fripher/estanteria-dulces/Previsualizacion cliente.png

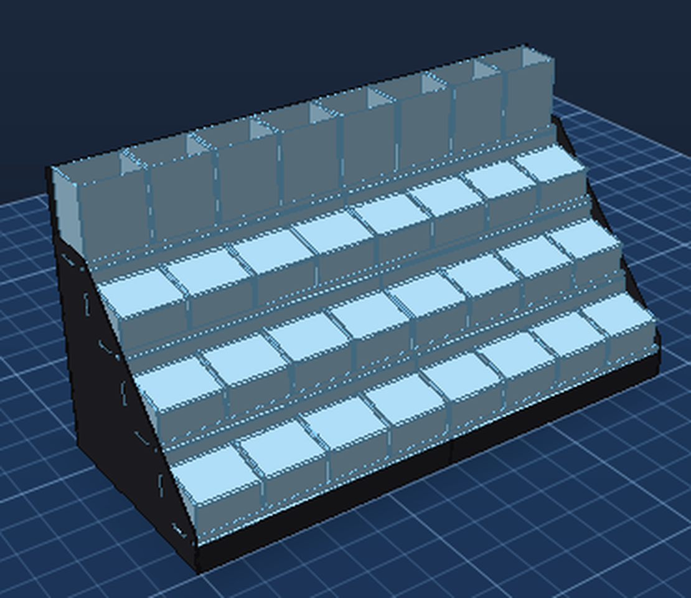
Previsualizacion cliente.png
