fripher/estanteria-dulces/FRIPHER 3D armada.png

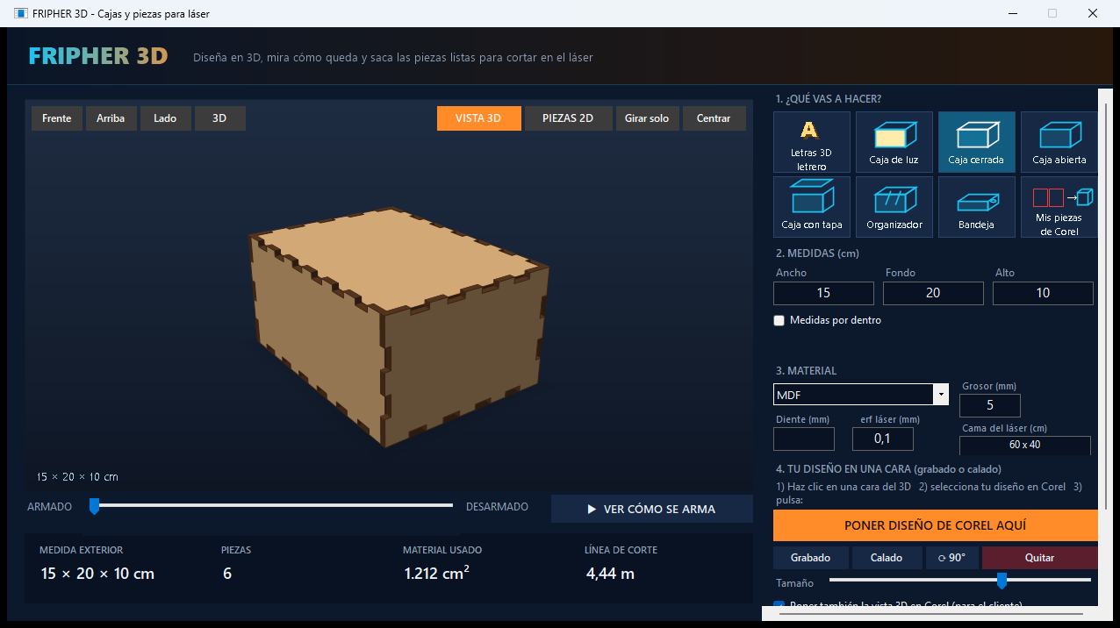
FRIPHER 3D armada.png
