fripher/estanteria-dulces/escalera armada afuera/LEEME.md

# Escalera de acrílico armada afuera

La escalera (pisos, contrahuellas, topes y soporte) se arma **sobre una mesa limpia**, con moldes, y cuando está
seca se mete **entera** dentro del mueble de MDF. Por eso estas piezas **no tienen las pestañas que entraban en el
MDF**: quedan 1 mm más cortas por cada lado para que entren sin forzar.

## Archivos
- `SOPORTE NUEVO con huecos LED`: soporte del medio en acrílico 5 mm, con 3 huecos de 13 mm para pasar la tira.
- `PISO …`, `CONTRAHUELLA …`, `TOPE …`: las piezas sin pestañas hacia el MDF (acrílico 5 mm).
- `MOLDES MDF 12mm costados falsos y galgas`: 2 costados falsos (la forma de la escalera) y 8 galgas para los topes.

## Reusar piezas viejas que estén limpias
- Pisos, contrahuellas y topes: corta **9 mm** de la punta que entraba al **costado** (la punta SIN dientes).
- Piso 4: además corta **9 mm** del borde de **atrás** (el que entraba al fondo).
- El soporte viejo no sirve: usa el nuevo (sin pestañas atrás y con los huecos de luz).

## Armado
1. Mesa limpia y plana, cartón limpio encima, **guantes de nitrilo**.
2. Costados falsos **parados** cerca de los dos extremos (a unos 5 cm de las puntas) y el soporte nuevo en el centro.
   Los costados falsos **no se pegan**: ponles cinta de enmascarar donde toca el acrílico.
3. De abajo hacia arriba: piso 1 (izq. y der.) → contrahuella 1 parada encima, contra la cara del costado falso →
   **tira LED** → piso 2 encima → … → piso 4.
4. Topes: la galga se cuelga del borde de adelante del piso; el tope se apoya contra ella (queda a 8 mm del borde).
5. Pegante espeso, papel protector puesto (solo una franjita de 4 mm quitada en cada unión).
6. Seca **toda la noche** sin moverla. Al otro día: sacas los costados falsos y metes la escalera en el mueble.

## Fijarla al mueble
Por detrás del piso 4 contra el fondo y en los extremos contra los costados: **silicona neutra transparente** en
puntos, o cinta **VHB**. Nada de cloruro ni Bóxer sobre el vinilo.
