fripher/estanteria-dulces/Bisagra cerrada.png

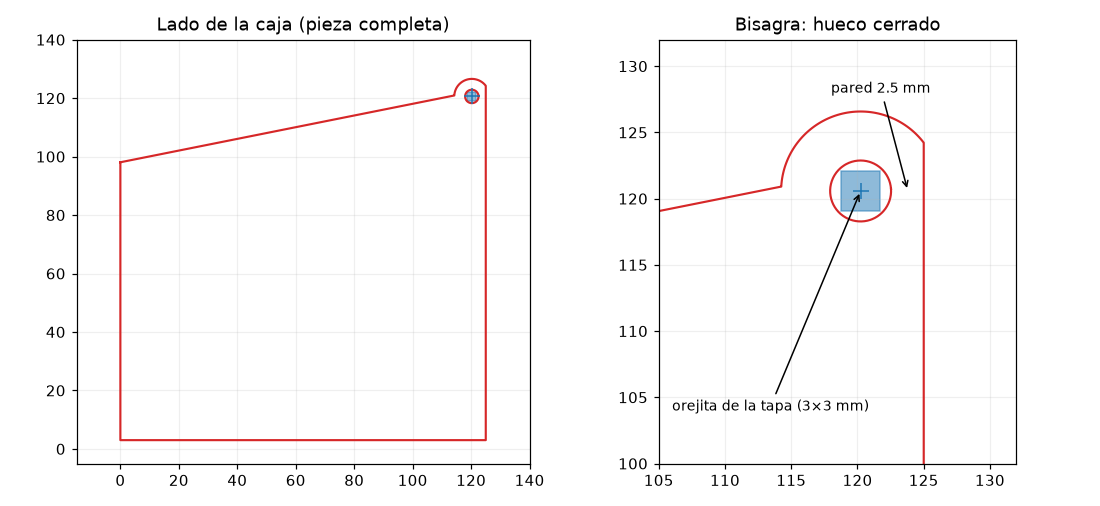
Bisagra cerrada.png
