fripher/estanteria-dulces/como poner la tira LED.png

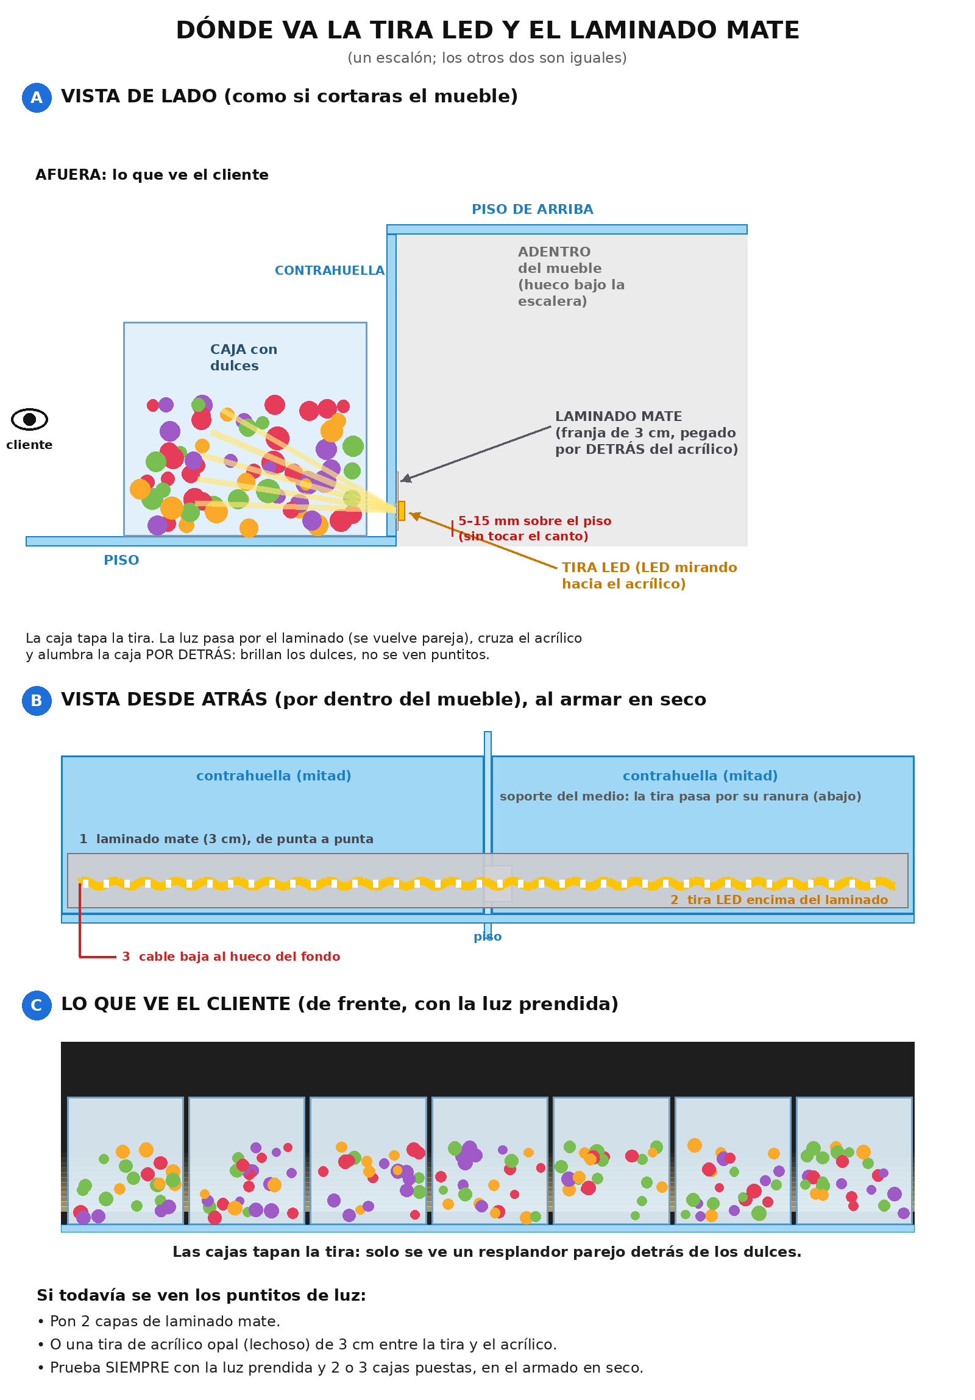
como poner la tira LED.png
