fripher/estanteria-dulces/huecos soporte para tira LED.png

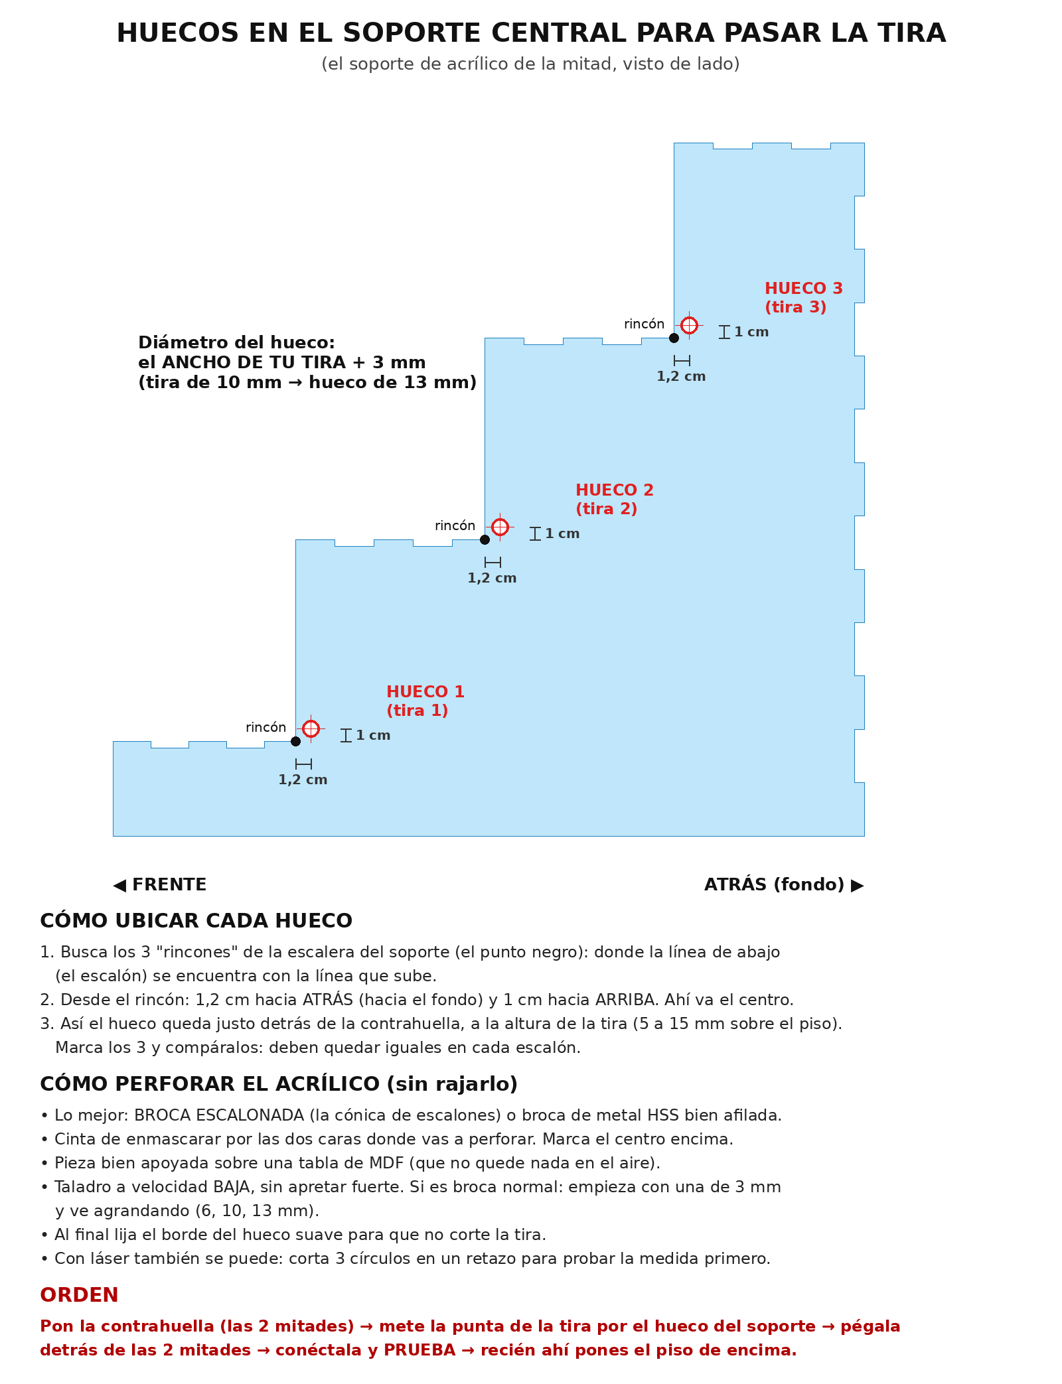
huecos soporte para tira LED.png
