fripher/estanteria-dulces/Impresion 3D/Protectores 3D vista.png

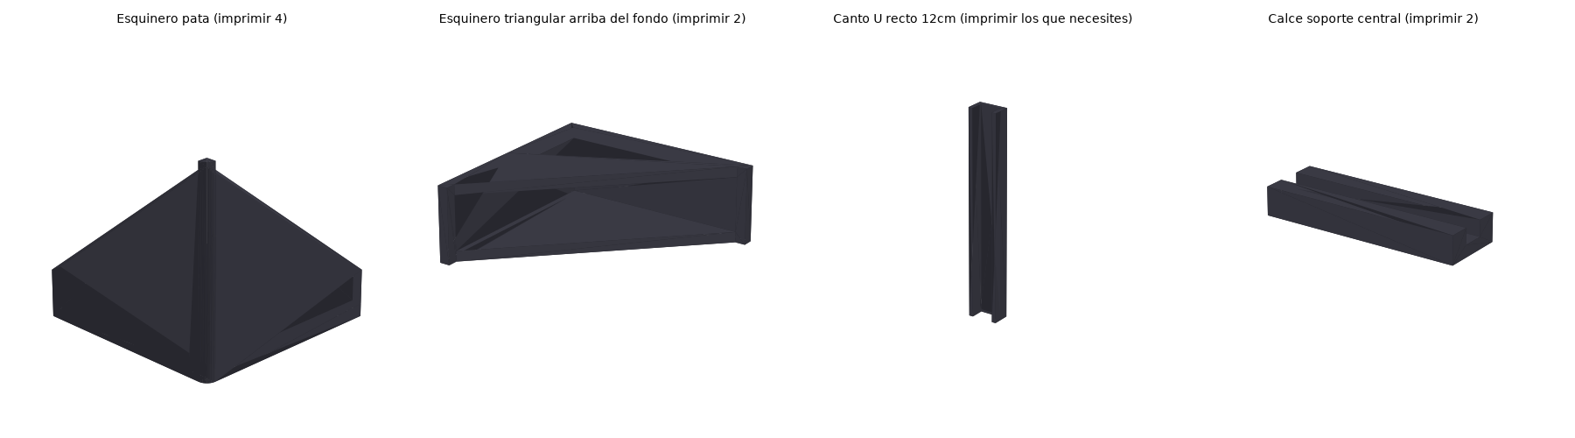
Impresion 3D/Protectores 3D vista.png
