fripher/estanteria-dulces/Lamina piso 4.png

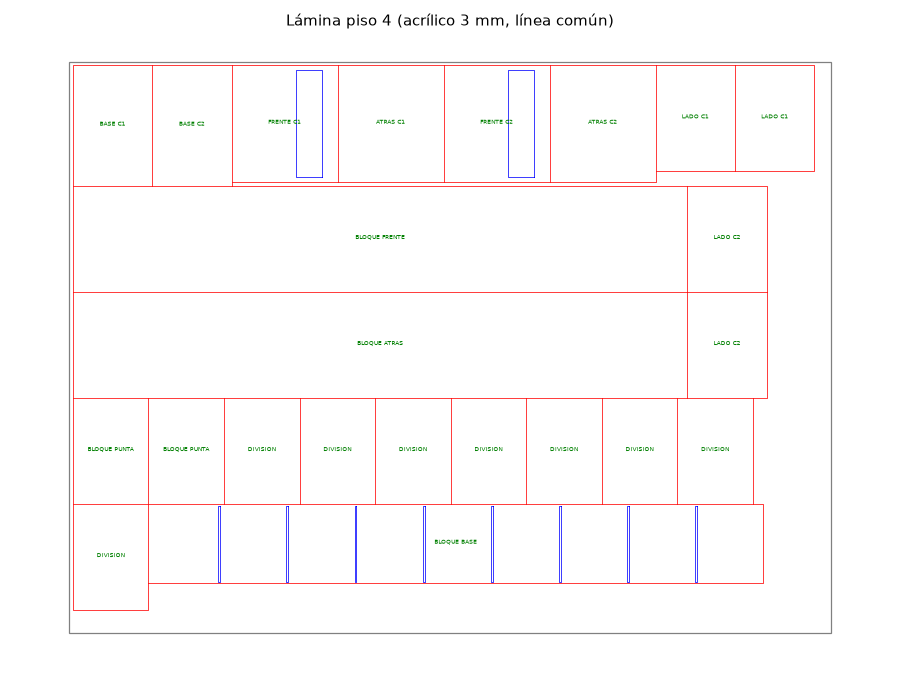
Lamina piso 4.png
