fripher/estanteria-dulces/Laminas 3mm ahorro.png

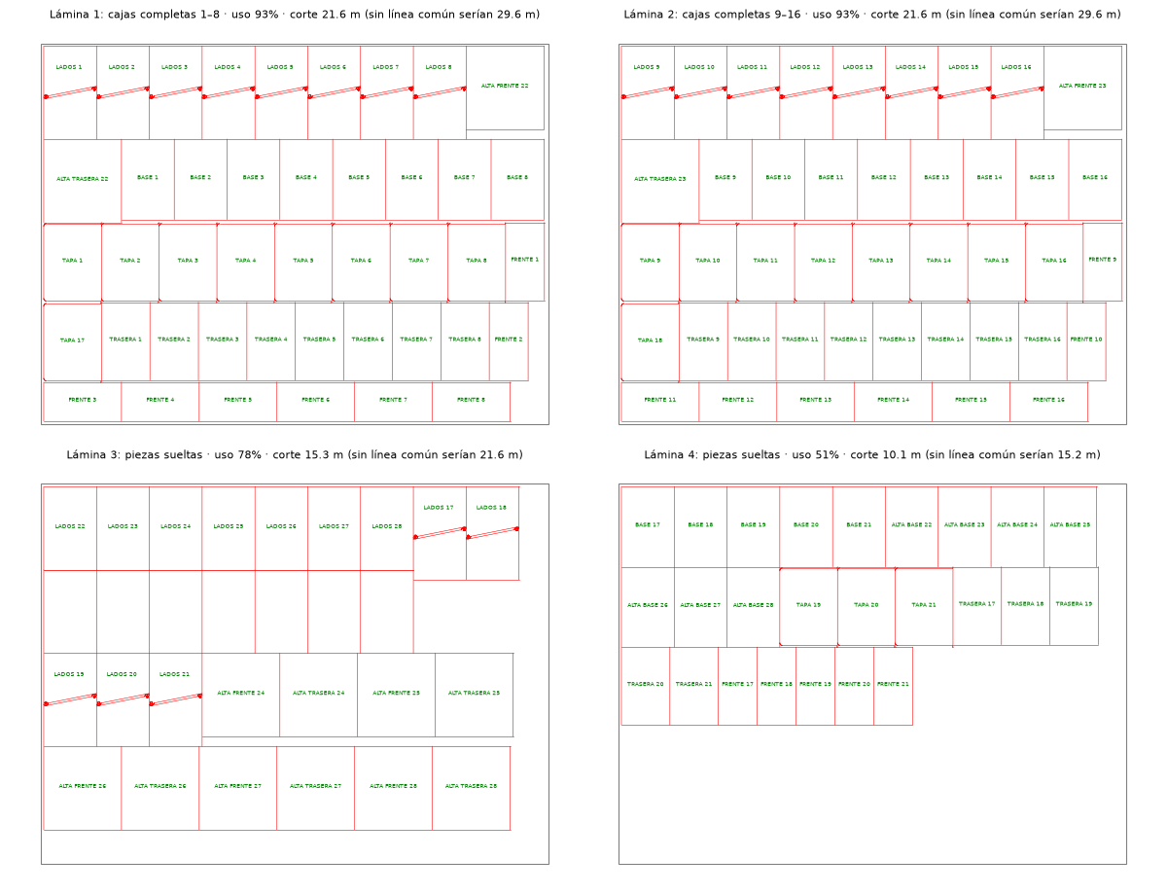
Laminas 3mm ahorro.png
