fripher/estanteria-dulces/Laminas 3mm cajas completas.png

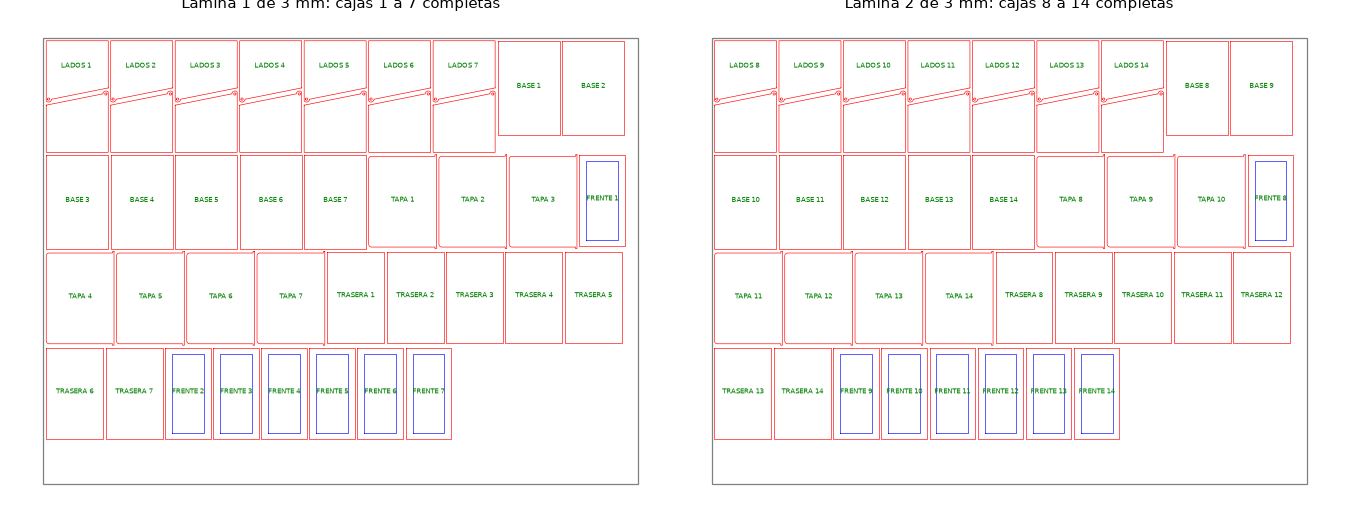
Laminas 3mm cajas completas.png
