fripher/estanteria-dulces/luces LED.png

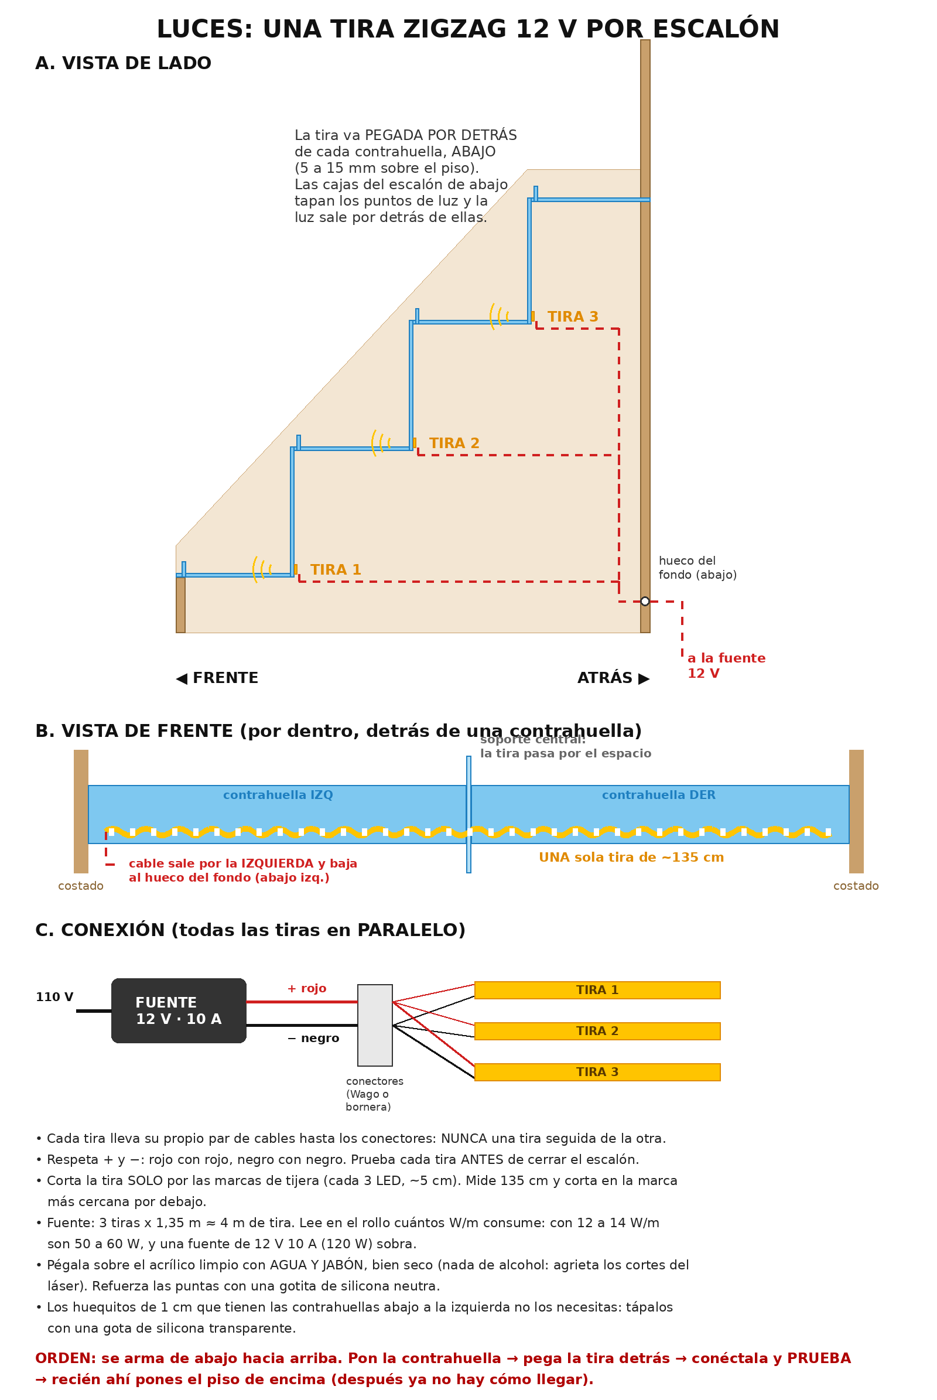
luces LED.png
