fripher/estanteria-dulces/Marco con ventanas.png

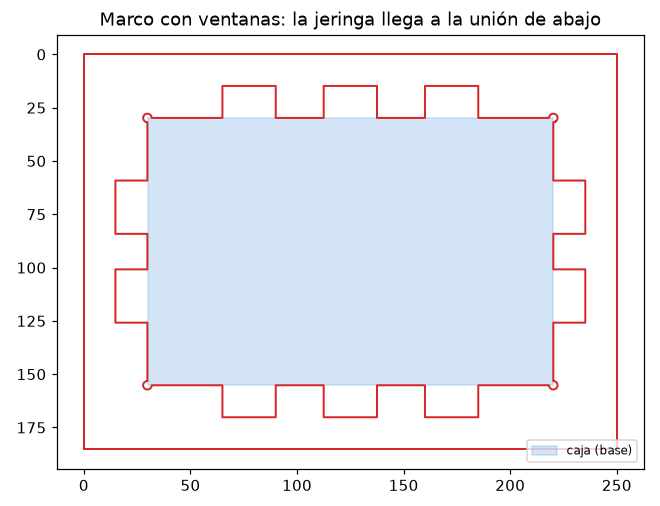
Marco con ventanas.png
