fripher/estanteria-dulces/Molde con lunitas.png

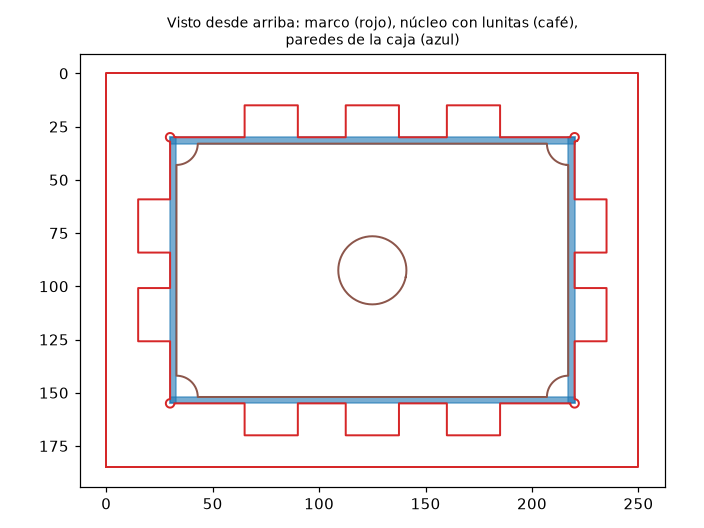
Molde con lunitas.png
