fripher/estanteria-dulces/Molde paso a paso.png

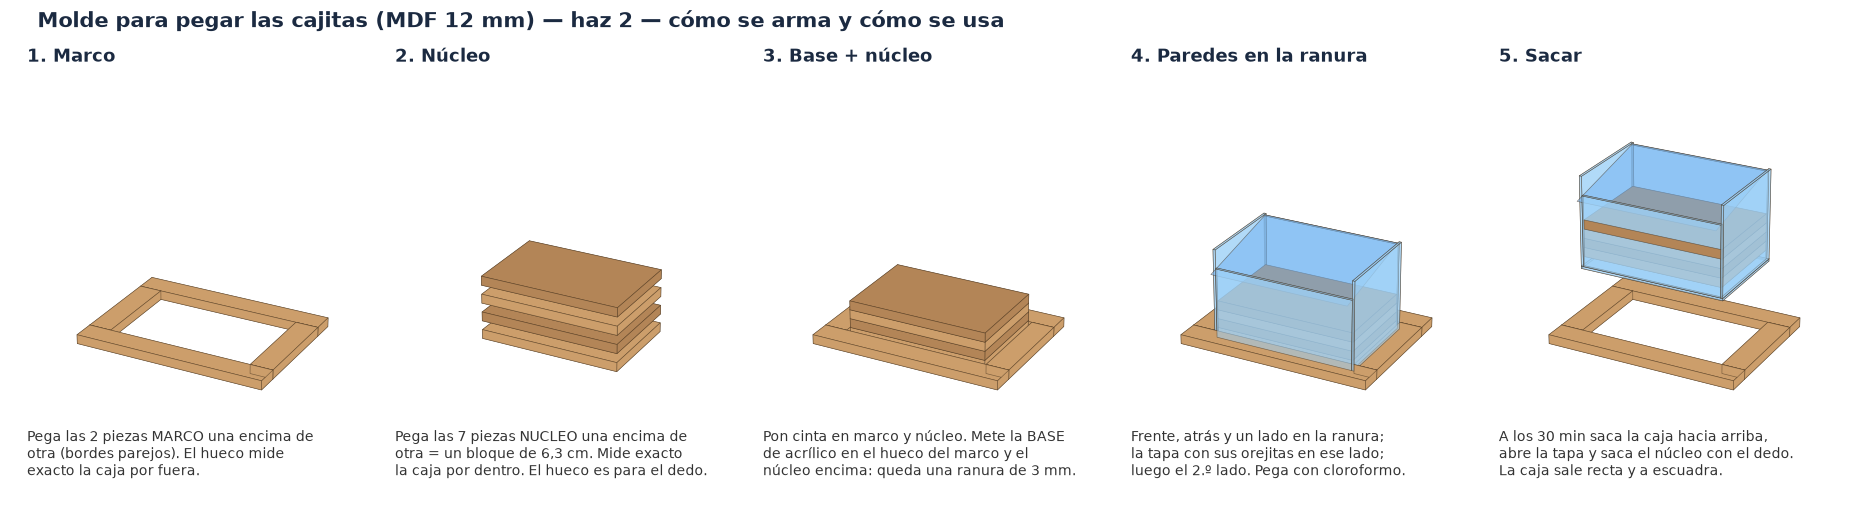
Molde paso a paso.png
