fripher/estanteria-dulces/Piso 4 de frente.png

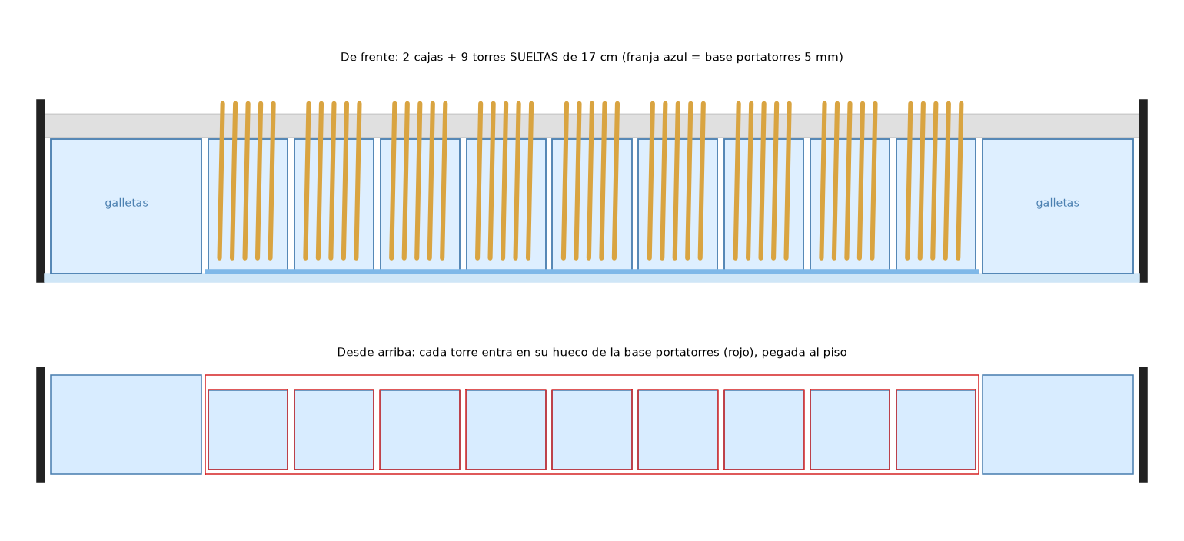
Piso 4 de frente.png
