fripher/estanteria-dulces/Piso 4 kits retazos.png

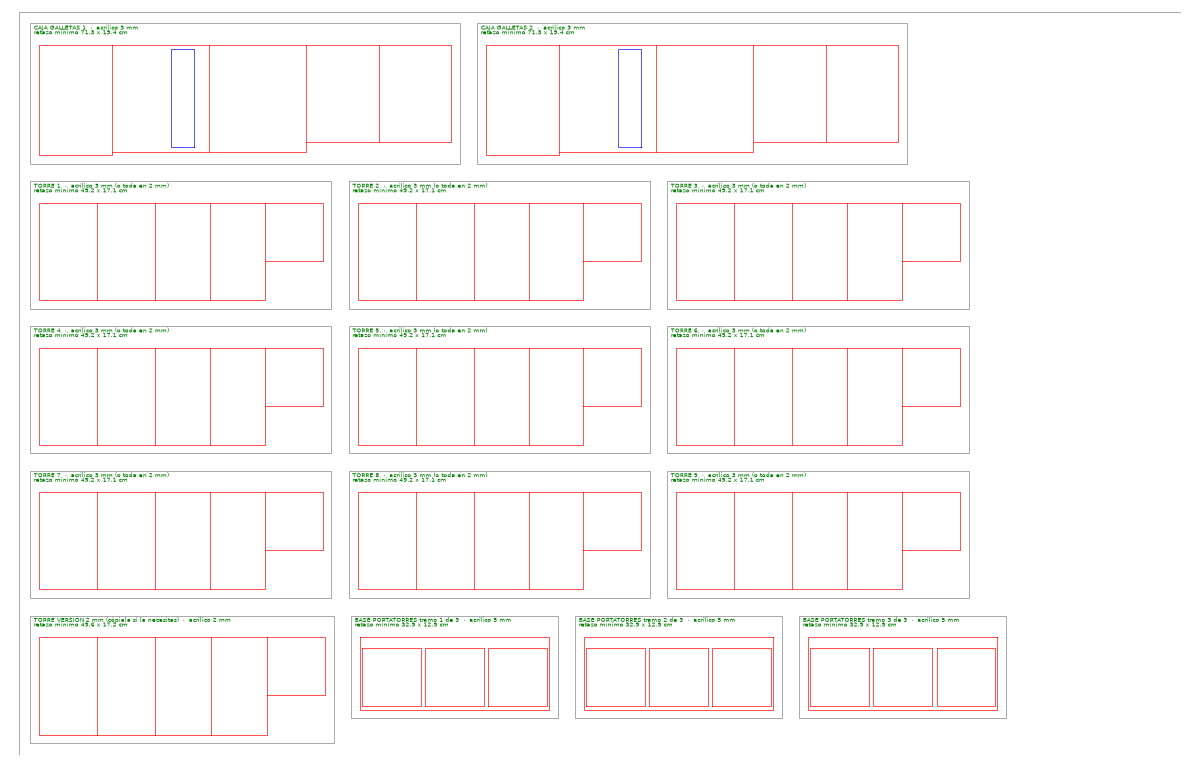
Piso 4 kits retazos.png
