fripher/estanteria-dulces/plano cajas.png

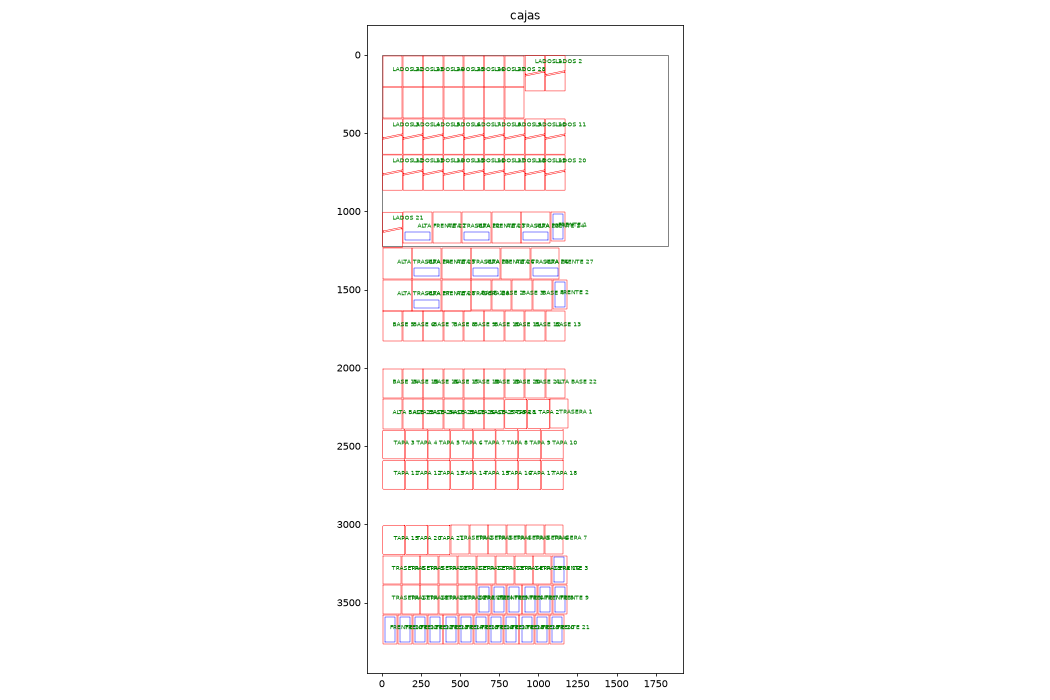
plano cajas.png
