fripher/estanteria-dulces/plano mdf.png

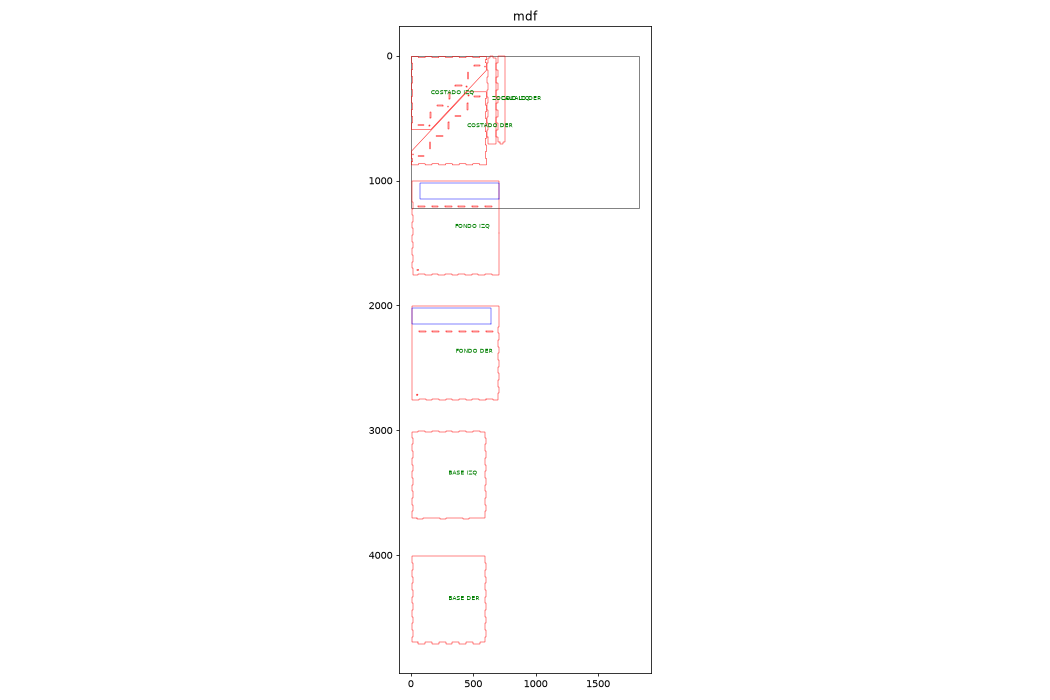
plano mdf.png
