fripher/estanteria-dulces/plano molde.png

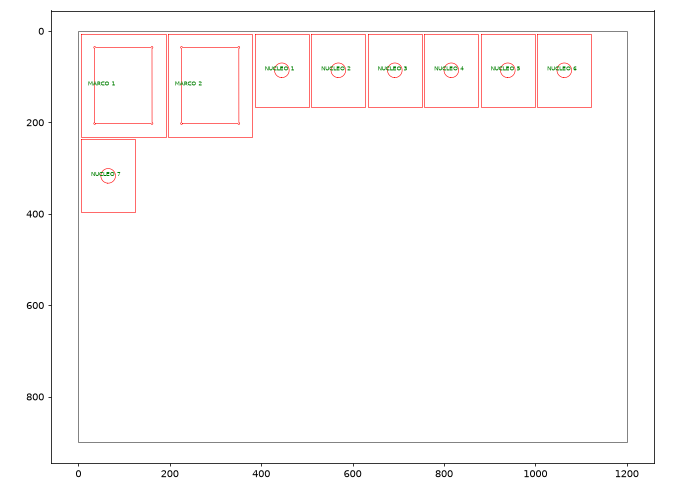
plano molde.png
