fripher/estanteria-dulces/plano negro.png

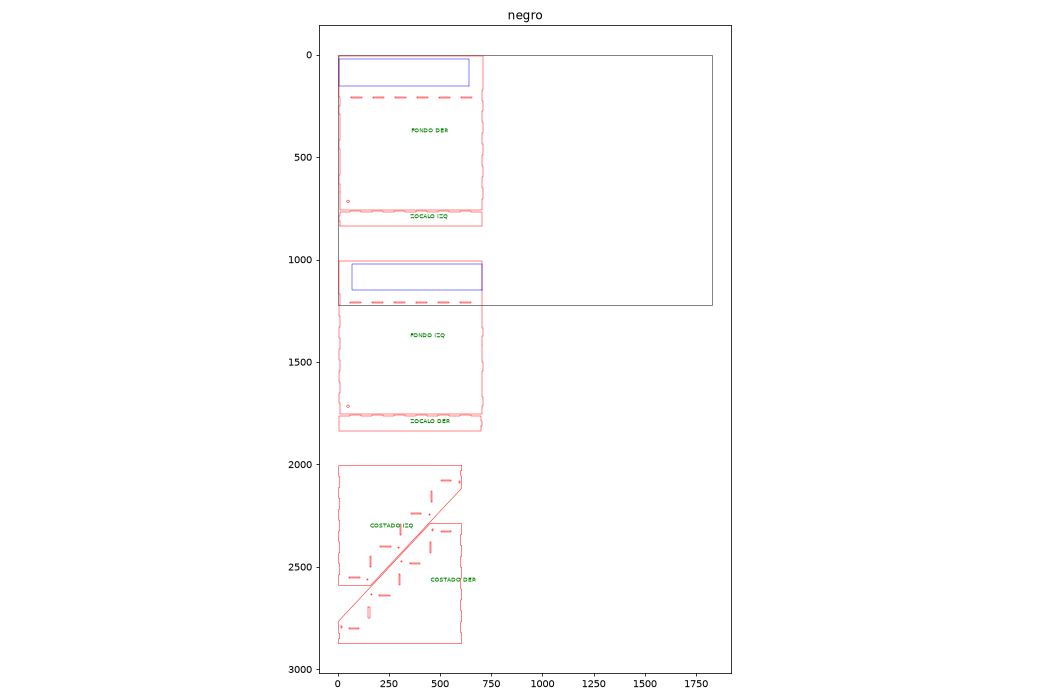
plano negro.png
