fripher/estanteria-dulces/plano opal.png

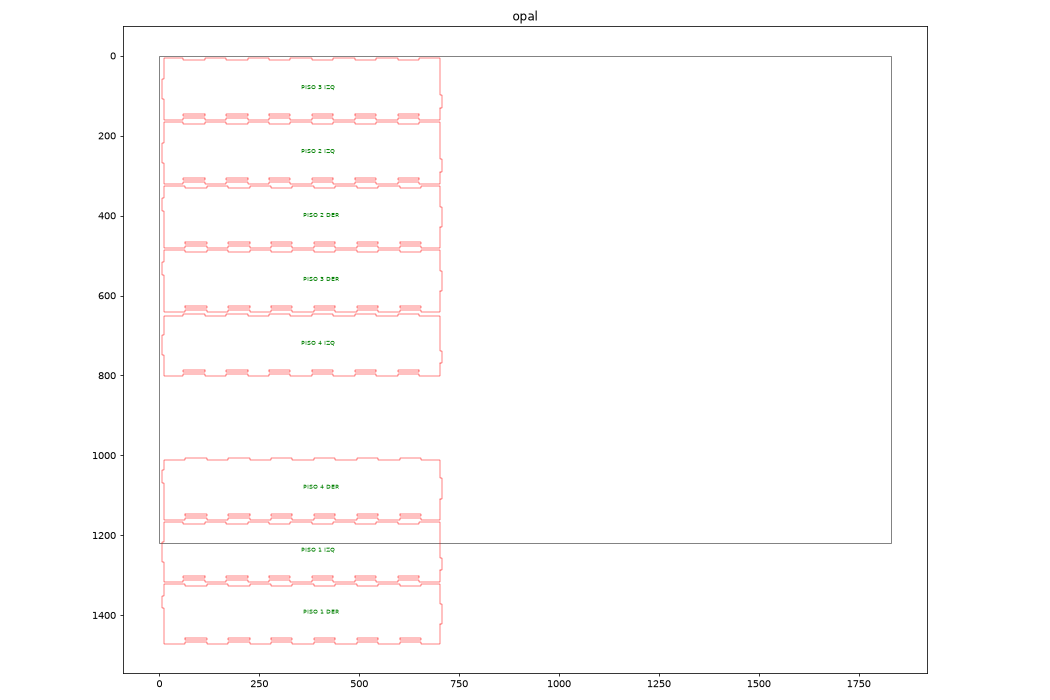
plano opal.png
