fripher/estanteria-dulces/plano transparente.png

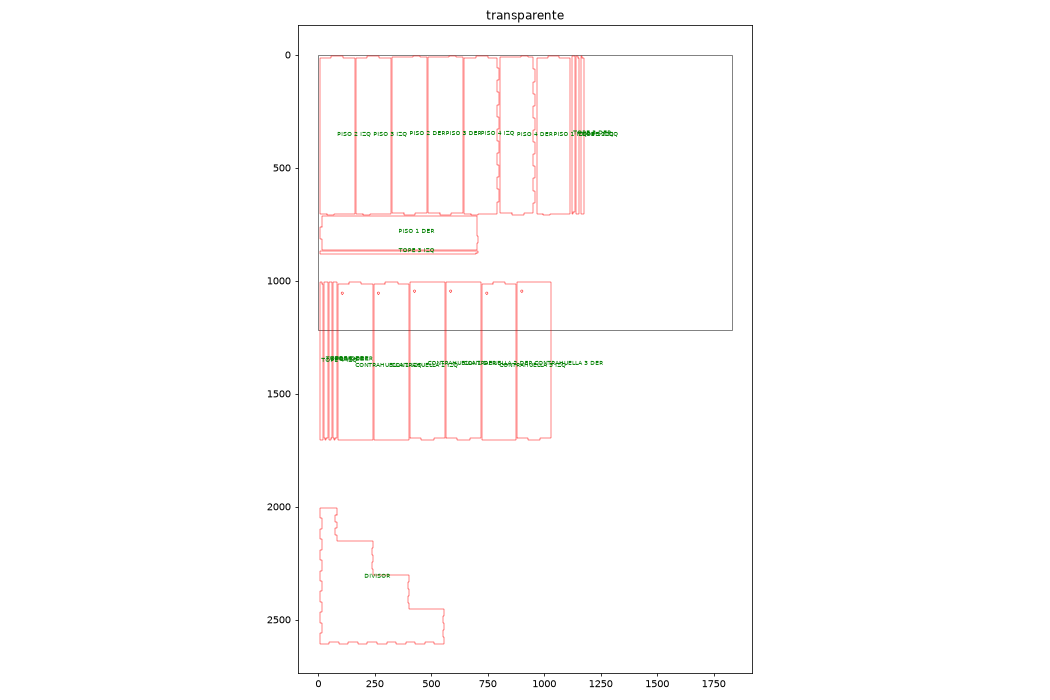
plano transparente.png
