fripher/estanteria-dulces/vinilo/como forrar.png

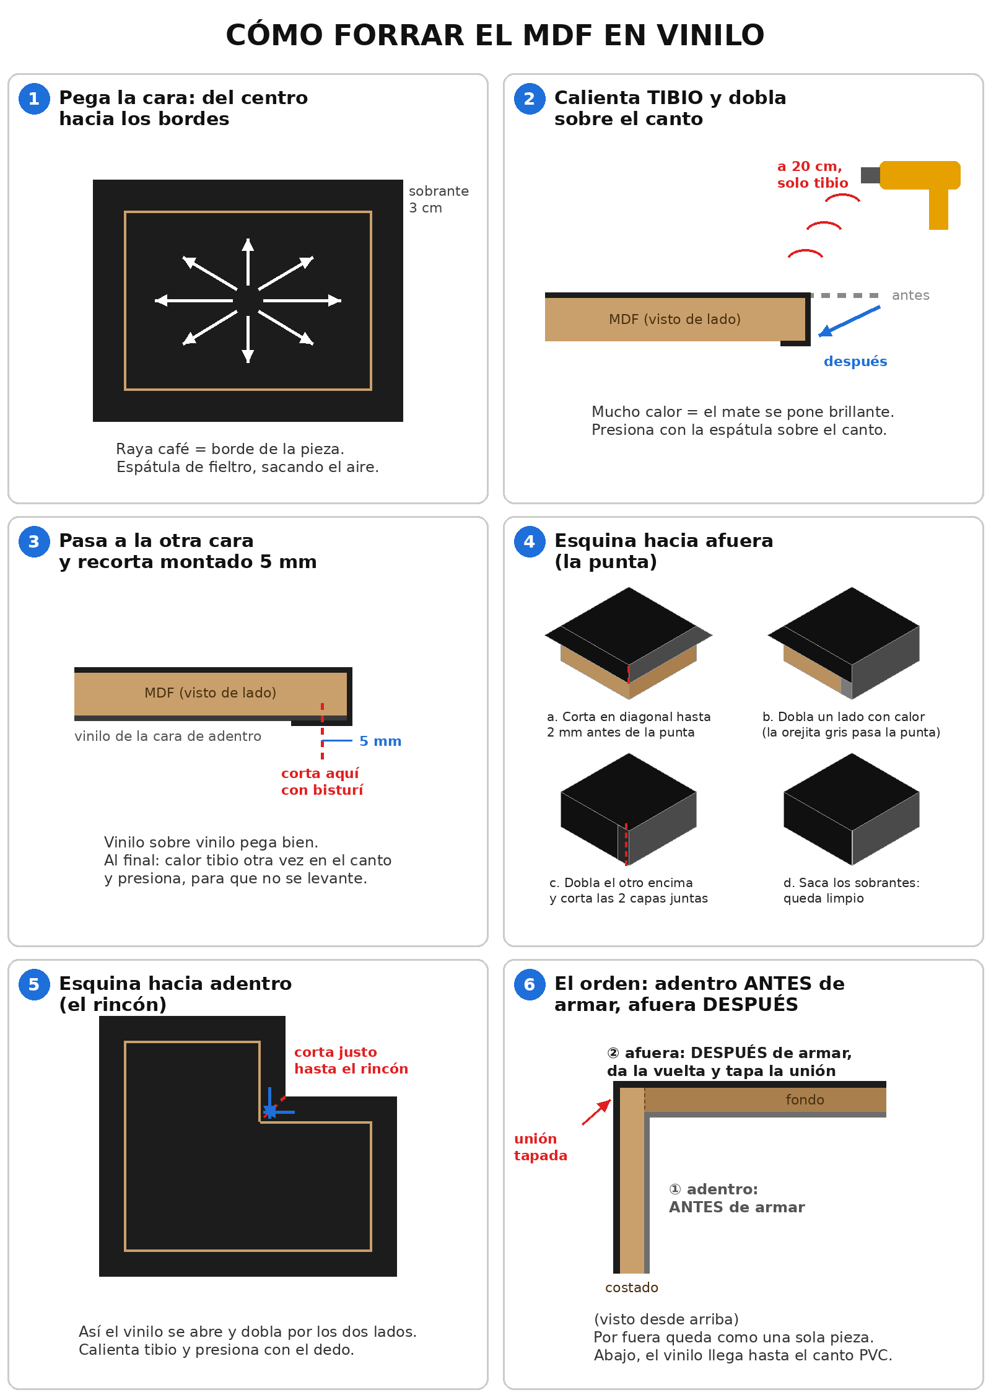
vinilo/como forrar.png
