fripher/estanteria-dulces/vista 3D.png

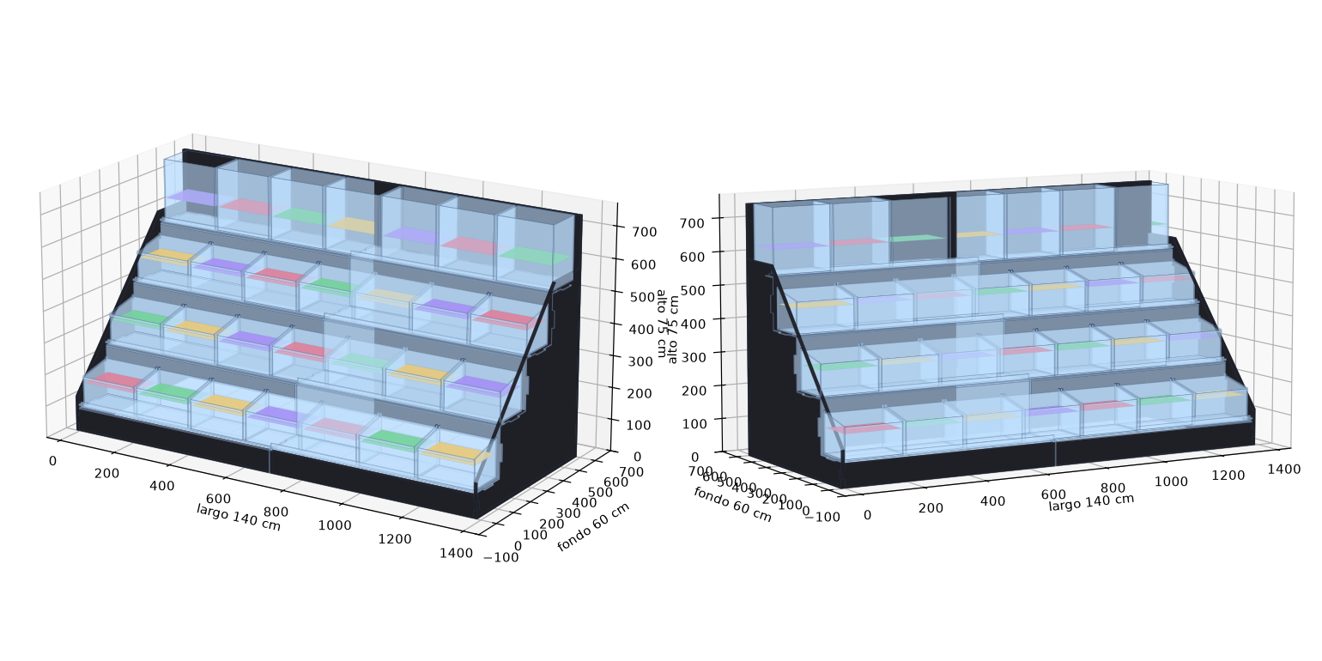
vista 3D.png
