fripher/estanteria-dulces/Vistas cliente.png

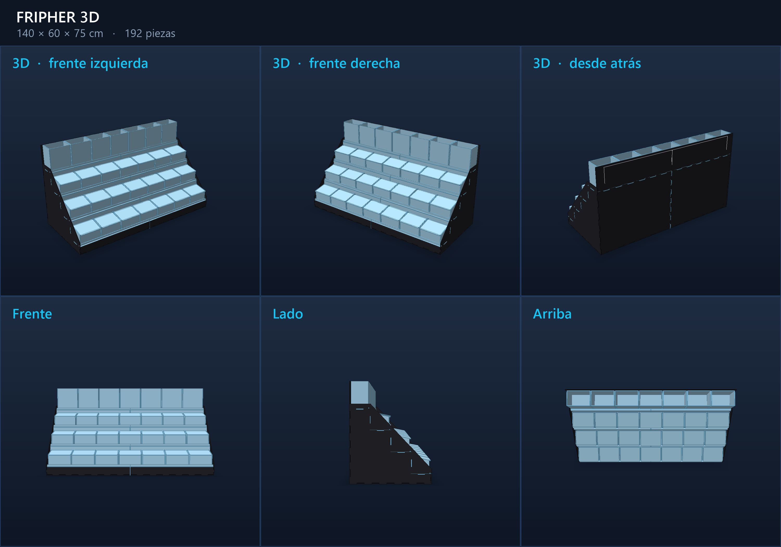
Vistas cliente.png
