fripher/estanteria-dulces/camara_laser/patron_calibracion.dxf

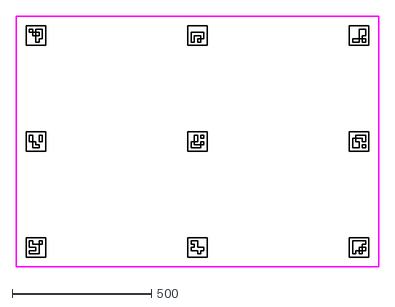
[picture p25: CAD file, 2026-10-23]
camara_laser/patron_calibracion.dxf
1300.0 x 900.0
