fripher/estanteria-dulces/Impresion 3D/TODO para imprimir.stl

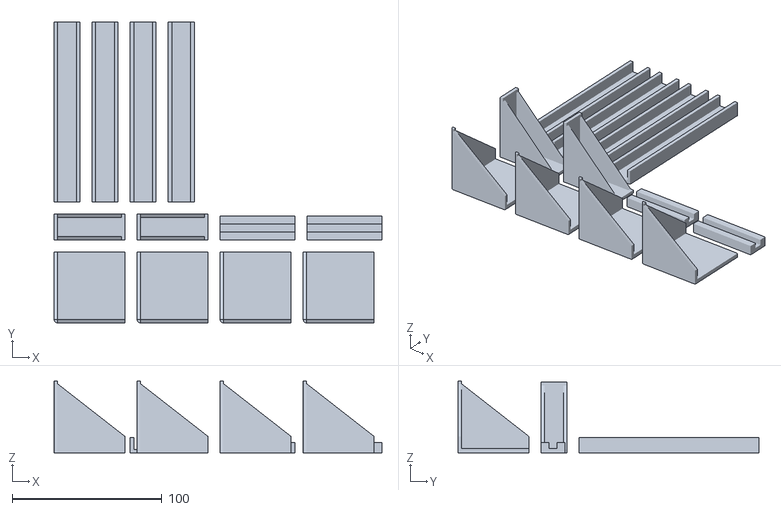
[picture p26: CAD file, 2026-10-22]
Impresion 3D/TODO para imprimir.stl
218.8 x 200.8 x 48.0
