fripher/estanteria-dulces/Impresion 3D/Calce soporte central (imprimir 2).stl

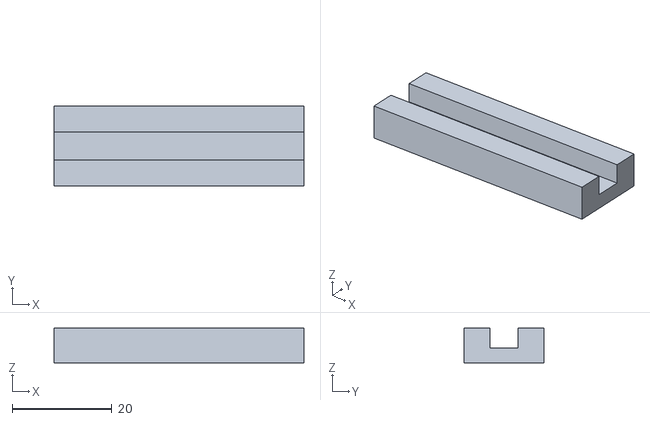
[picture p27: CAD file, 2026-10-22]
Impresion 3D/Calce soporte central (imprimir 2).stl
50.0 x 16.0 x 7.00
