fripher/estanteria-dulces/Impresion 3D/Esquinero pata (imprimir 4).stl

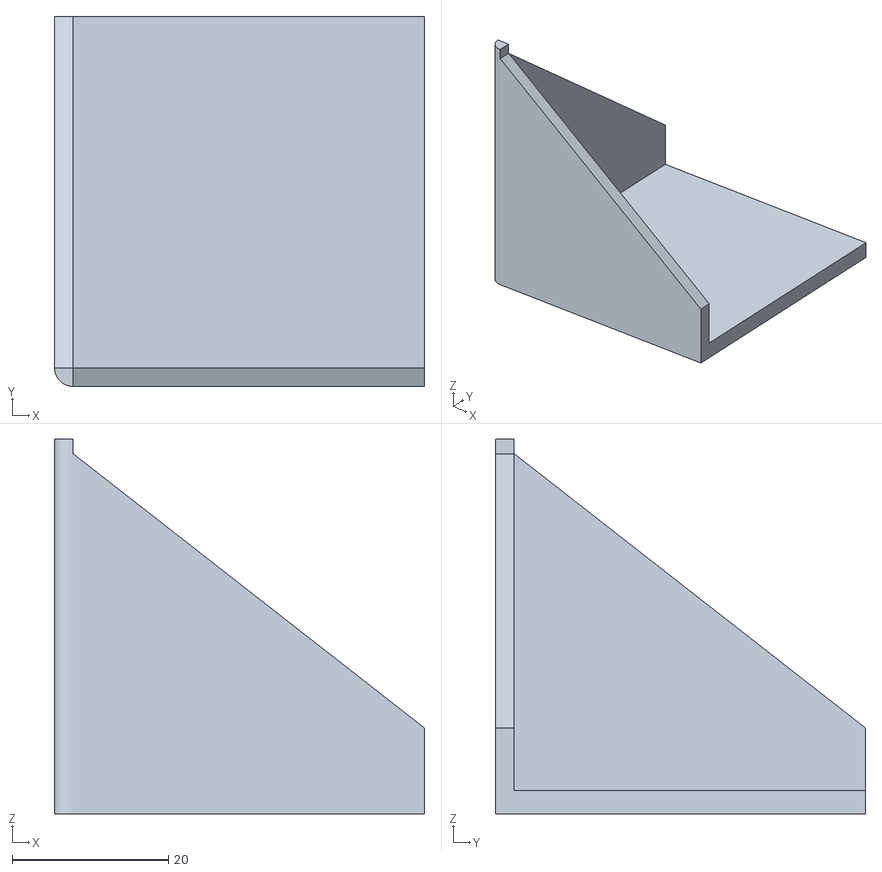
[picture p28: CAD file, 2026-10-22]
Impresion 3D/Esquinero pata (imprimir 4).stl
47.4 x 47.4 x 48.0
