fripher/estanteria-dulces/Impresion 3D/Canto U recto 12cm (imprimir los que necesites).stl

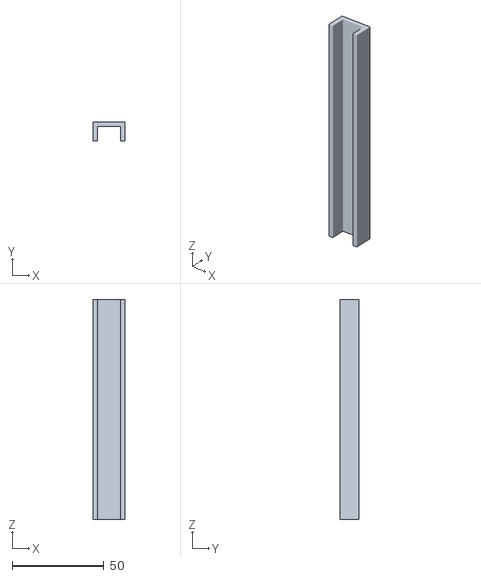
[picture p29: CAD file, 2026-10-22]
Impresion 3D/Canto U recto 12cm (imprimir los que necesites).stl
17.4 x 10.4 x 120.0
