fripher/estanteria-dulces/Impresion 3D/Esquinero triangular arriba del fondo (imprimir 2).stl

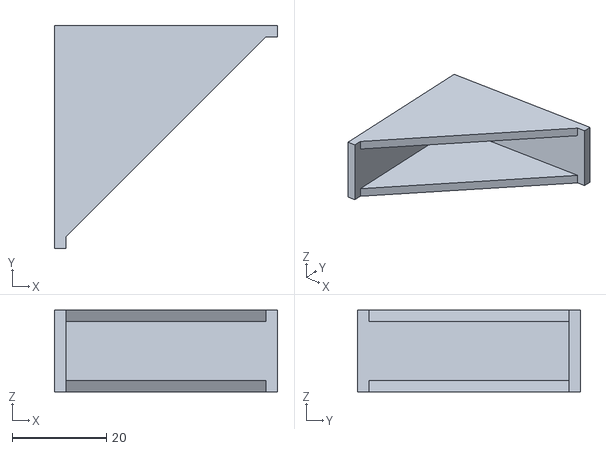
[picture p30: CAD file, 2026-10-22]
Impresion 3D/Esquinero triangular arriba del fondo (imprimir 2).stl
47.4 x 47.4 x 17.4
