fripher/estanteria-dulces/armado pisos y contrahuellas.png

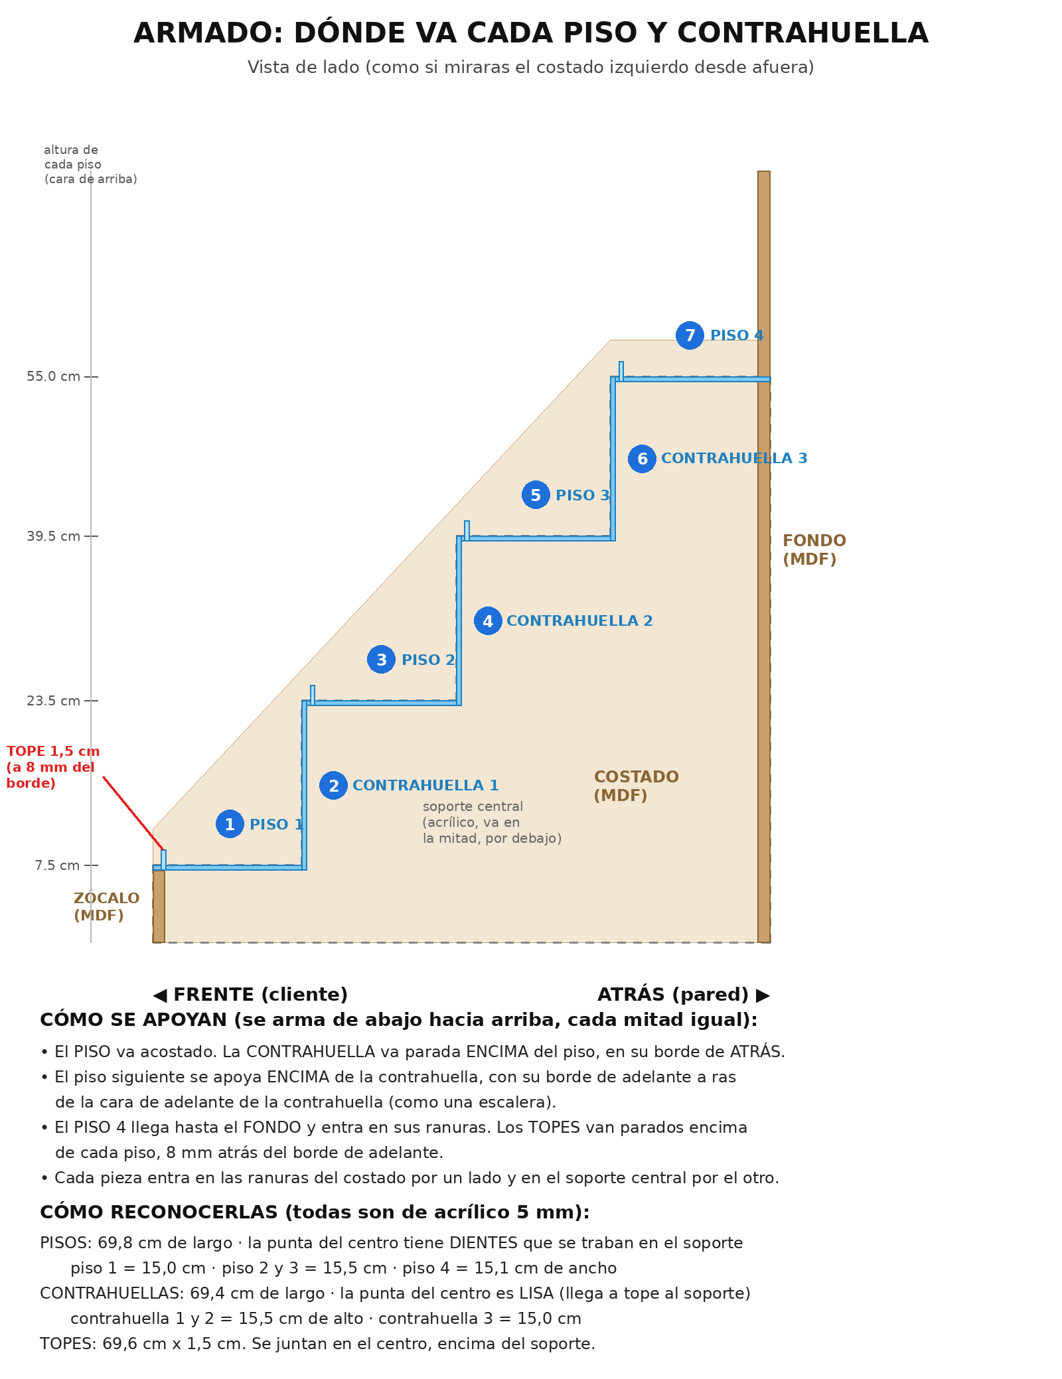
armado pisos y contrahuellas.png
