fripher/estanteria-dulces/(commit log)

2026-10-22 Estantería de dulces: generador paramétrico, cortes y piezas 3D
    [Calce soporte central (imprimir 2).stl, Canto U recto 12cm (imprimir los que necesites).stl, Esquinero pata (imprimir 4).stl, Esquinero triangular arriba del fondo (imprimir 2).stl, TODO para imprimir.stl]
2026-10-22 Puente nube-PC: órdenes por GitHub para manejar CorelDRAW con acciones fijas
    Claude-Session: https://claude.ai/code/session_01TmW22hwGtUP5ENmip5UCHg
2026-10-22 Platina de MDF para la unión del fondo + orden para ponerla en Corel
    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
2026-10-22 Vinilo: paneles negros tipo melamina a tamaño real para forrar el MDF
    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
2026-10-22 Guía ilustrada para forrar el MDF en vinilo
    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
2026-10-23 Dibujo de armado: dónde va cada piso y contrahuella
    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
2026-10-23 Dibujo de instalación de las luces LED
    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
2026-10-23 Dibujo: huecos en el soporte central para pasar la tira LED
    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
2026-10-23 Cámara para el láser: calibración con patrón grabado, detección de retazos y acomodo de piezas → DXF para RDWorks
    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
    [patron_calibracion.dxf]
2026-10-23 Cámara: config.json solo en el PC (sale de config_ejemplo.json)
    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
2026-10-23 Piezas sueltas de acrílico 5 mm, una por archivo, para recortar repuestos
    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
2026-10-23 Forro exterior de los costados en acrílico negro 3 mm + orden para Corel
    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
2026-10-23 Forro de costados: las 2 piezas lado a lado (sí caben en la lámina)
    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
2026-10-24 Escalera armada afuera: piezas sin pestañas, soporte con huecos LED y moldes de armado
    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
2026-10-24 Soporte nuevo igual al original (pestañas al fondo) con 3 ranuras abiertas para la tira LED
    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
2026-10-24 Dibujo: cómo poner la tira LED con laminado mate detrás de la contrahuella
    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
2026-10-24 Cenefas de acrílico negro 2 mm para tapar el neón en el borde de cada nivel
    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
2026-10-24 Topes negros que tapan el neón (reemplazan las cenefas sueltas)
    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
2026-10-24 Soporte central con paso para el neón por debajo de los pisos 2, 3 y 4
    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
2026-10-24 16 escuadras de armado en MDF para sostener el acrílico a 90° mientras se pega
    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
2026-10-24 Escuadras: ancho correcto (602 mm) en la orden de Corel
    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
2026-10-24 Puente: listar documentos y reimportar escuadras a 602 mm
    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
2026-10-24 Puente: abrir el soporte en Corel
    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
2026-10-24 Frente del zócalo en acrílico negro 2 mm (tapa la unión MDF-acrílico y hace de tope del piso 1)
    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
2026-10-24 Lámina negra 2 mm 120x180 con todas las piezas negras (panel de arriba y zócalo de una pieza)
    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
